zivbeh/pcb_inverter/inverter/LTC3261EMSE_PBF.step

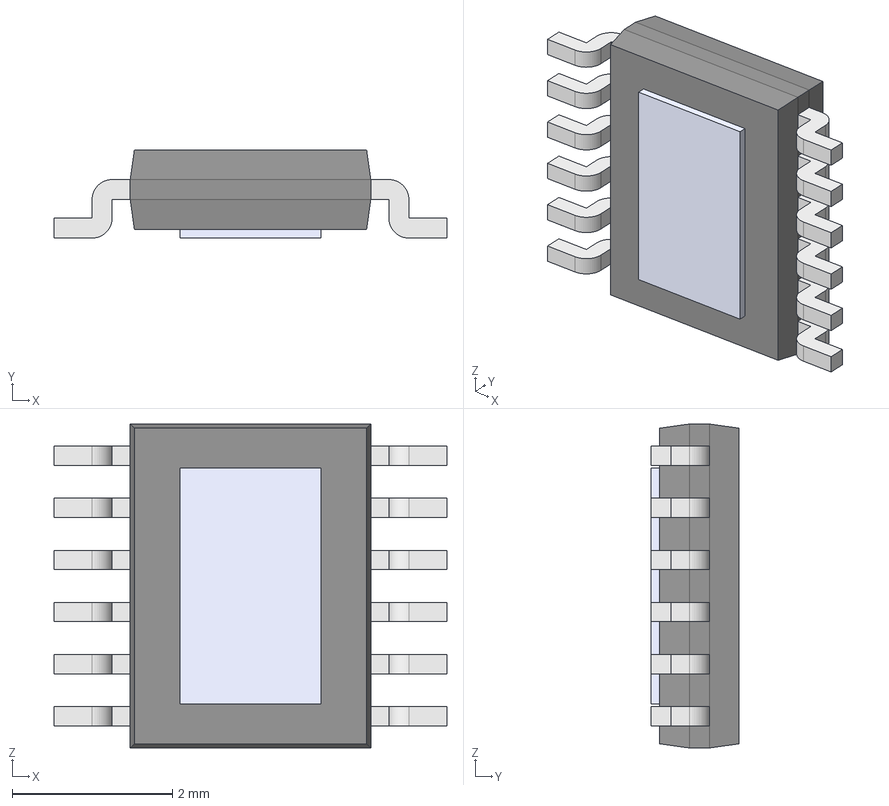
[picture p1: CAD file, 2026-02-18]
inverter/LTC3261EMSE_PBF.step
4.90 x 1.10 x 4.04 mm
Body001 (Mirror #1) x 6
XY-plane x 12
X-axis x 12
