zivbeh/pcb_inverter/(commit log)

2026-02-13 pcb v1
    [inverter.kicad_pcb, inverter.kicad_sch]
2026-02-17 added test points 1.5mm
    [inverter.kicad_pcb, inverter.kicad_sch]
2026-02-17 edge cuts and done
    [inverter.kicad_pcb, inverter.kicad_sch]
2026-02-17 minor changes
    [inverter.kicad_pcb]
2026-02-18 -15 to 15 done
    [LTC3261EMSE_PBF.step, inverter.kicad_pcb, inverter.kicad_sch]
2026-02-19 Add image to README for final board size
    Added image to README for better visualization.
